library-test-kitchen/electric-campfire/README.md

Electric Campfire
=================
<p>By Jenny Hong</p>

Getting Started
---------------

Download the DIY manual for [print](LTK-EC%20DIY%20print.pdf) or [online](LTK-EC%20DIY%20online.pdf) viewing!

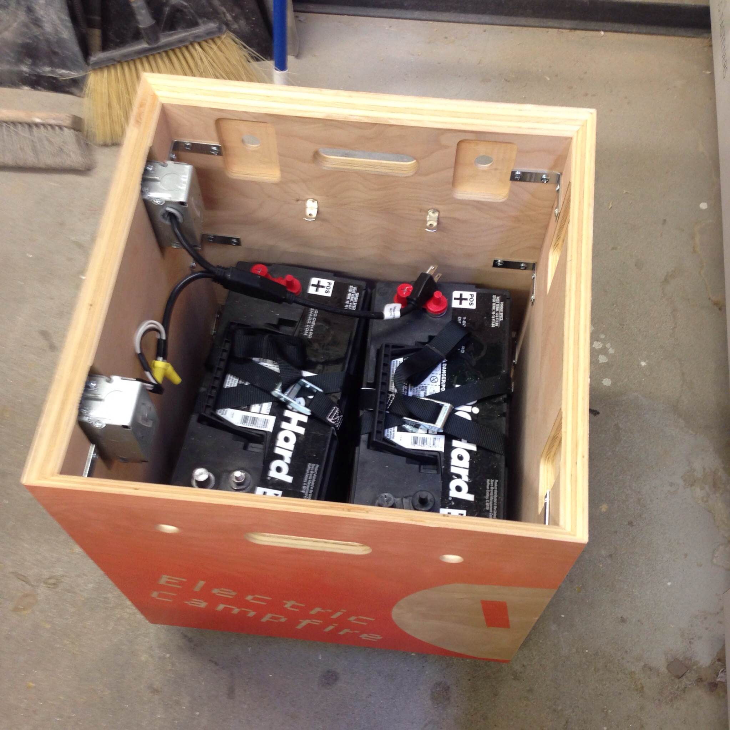
[picture p1: Documentation/v2.jpg]
open campfire
<br />
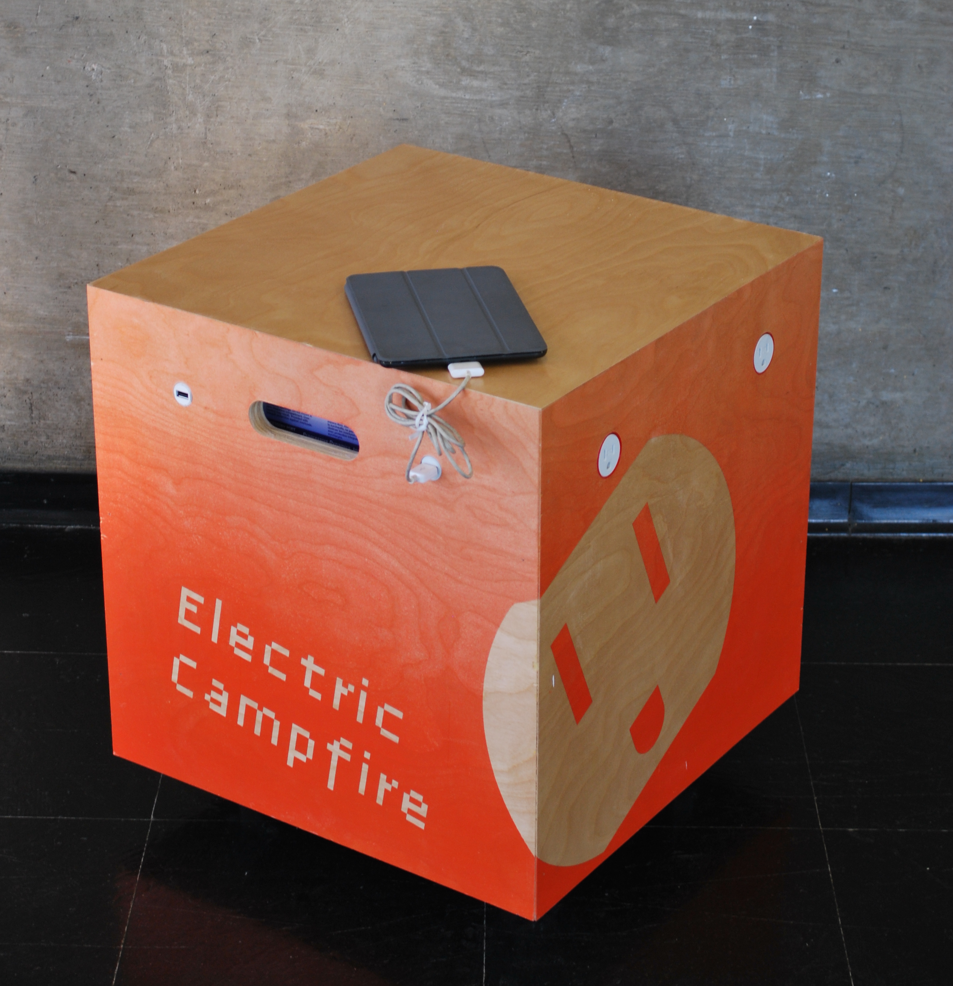
[picture p2: Documentation/ec_v2.JPG]
demo campfire
