library-test-kitchen/electric-campfire/Documentation/v1.jpg

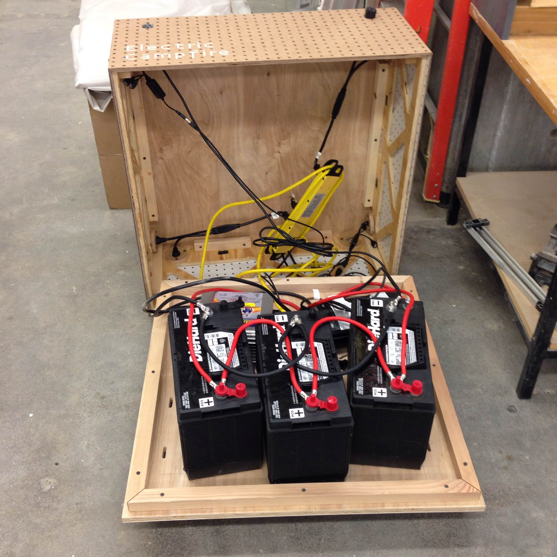
Documentation/v1.jpg
