library-test-kitchen/electric-campfire/Graphics - Laser Cutter Files/AUTOCAD_Electric-Campfire_Graphics_Laser-Cutter-File.jpg

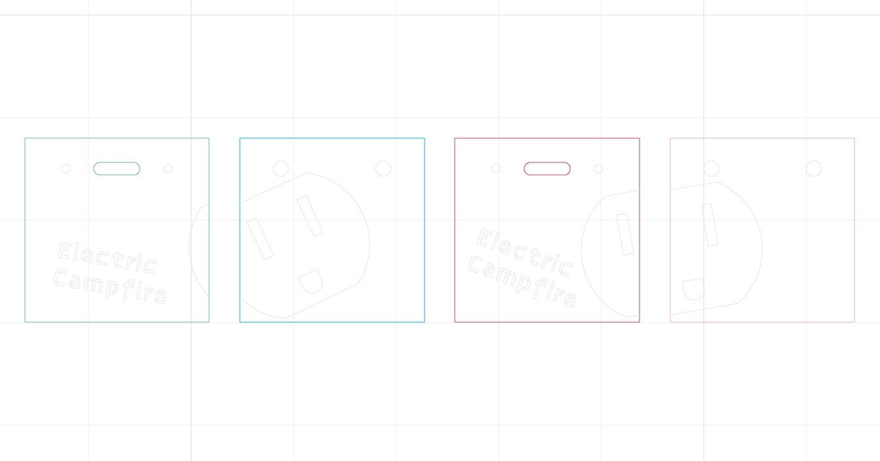
Graphics - Laser Cutter Files/AUTOCAD_Electric-Campfire_Graphics_Laser-Cutter-File.jpg
