library-test-kitchen/electric-campfire/(list of files, cad)

Other CAD files:
Graphics - Laser Cutter Files/AUTOCAD_Electric-Campfire_Graphics_Laser-Cutter-File.dwg
Mastercam/RHINO_Electric-Campfire_Mastercam-setup-mcx_7.3dm
